DanoPTT/CellBalancer_Attiny/Balancer_osadenie.JPG

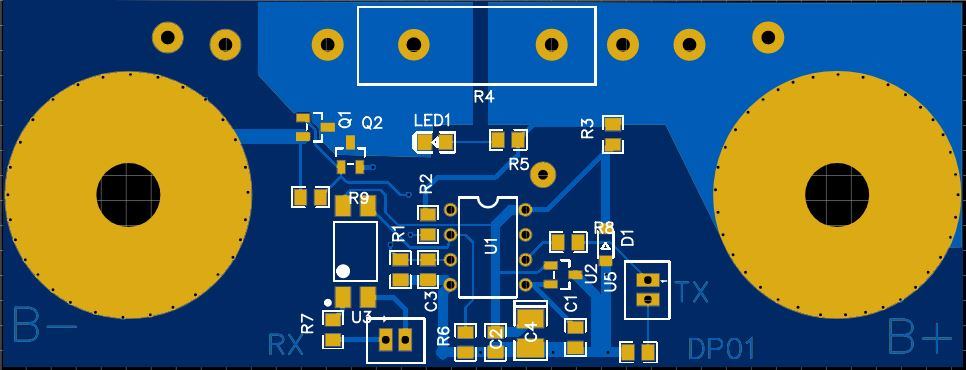
Balancer_osadenie.JPG
