DanoPTT/CellBalancer_Attiny/Pictures/Bottom.PNG

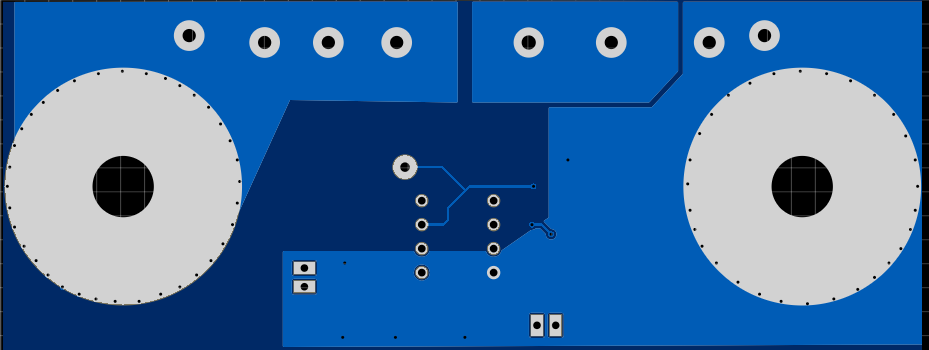
Pictures/Bottom.PNG
