DanoPTT/CellBalancer_Attiny/Schema/TXRX_Inverter.PNG

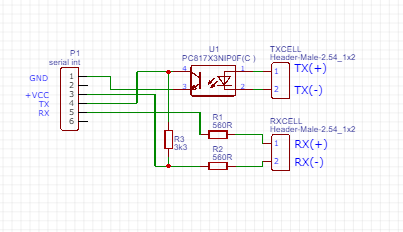
Schema/TXRX_Inverter.PNG
