DanoPTT/CellBalancer_Attiny/Pictures/FittedParts.JPG

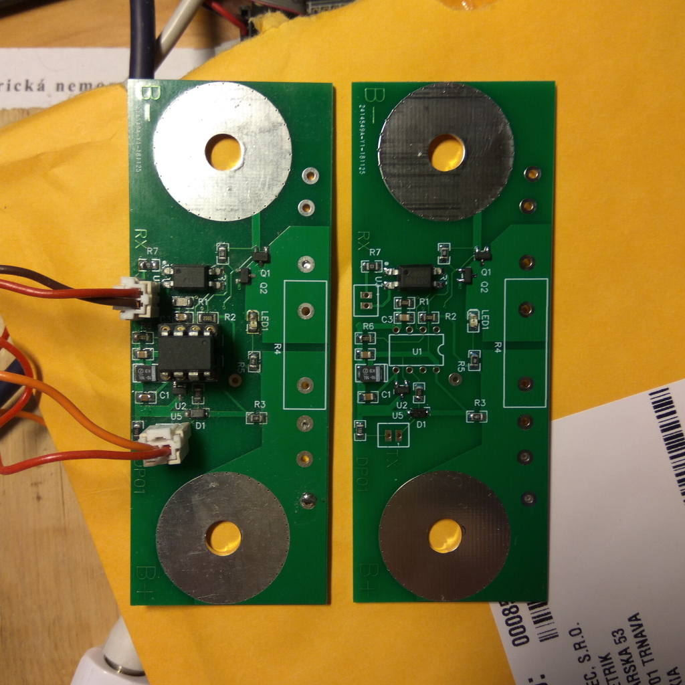
Pictures/FittedParts.JPG
