DanoPTT/CellBalancer_Attiny/Pictures/Installed.JPG

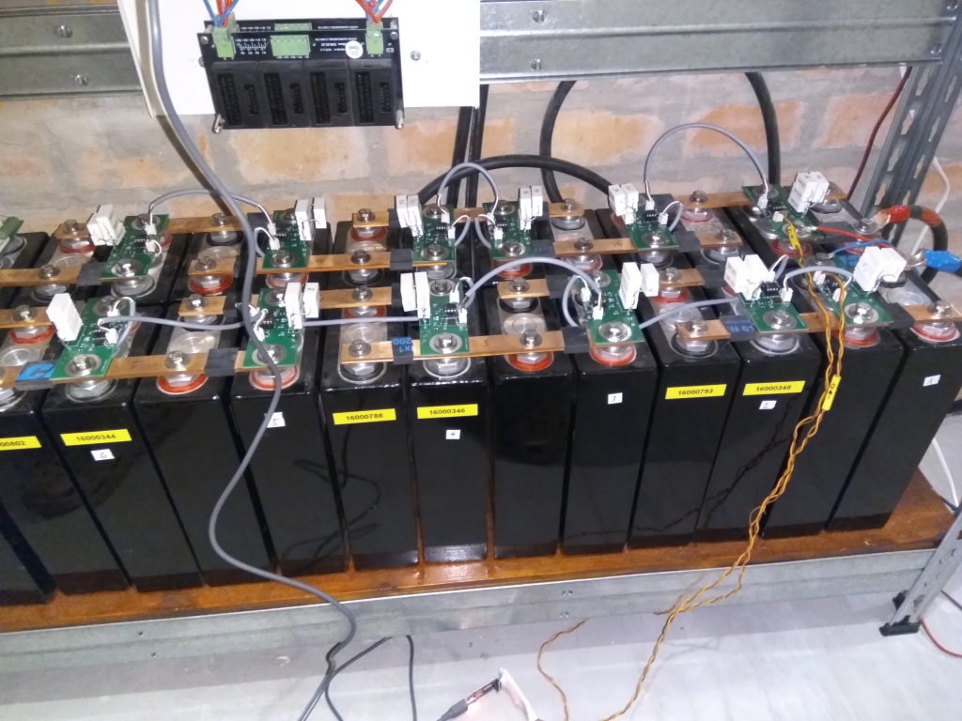
Pictures/Installed.JPG
