DanoPTT/CellBalancer_Attiny/Schema/Schematic_Cell-balancer-monitor-with-attiny85_Sheet-1_20181124230932.pdf

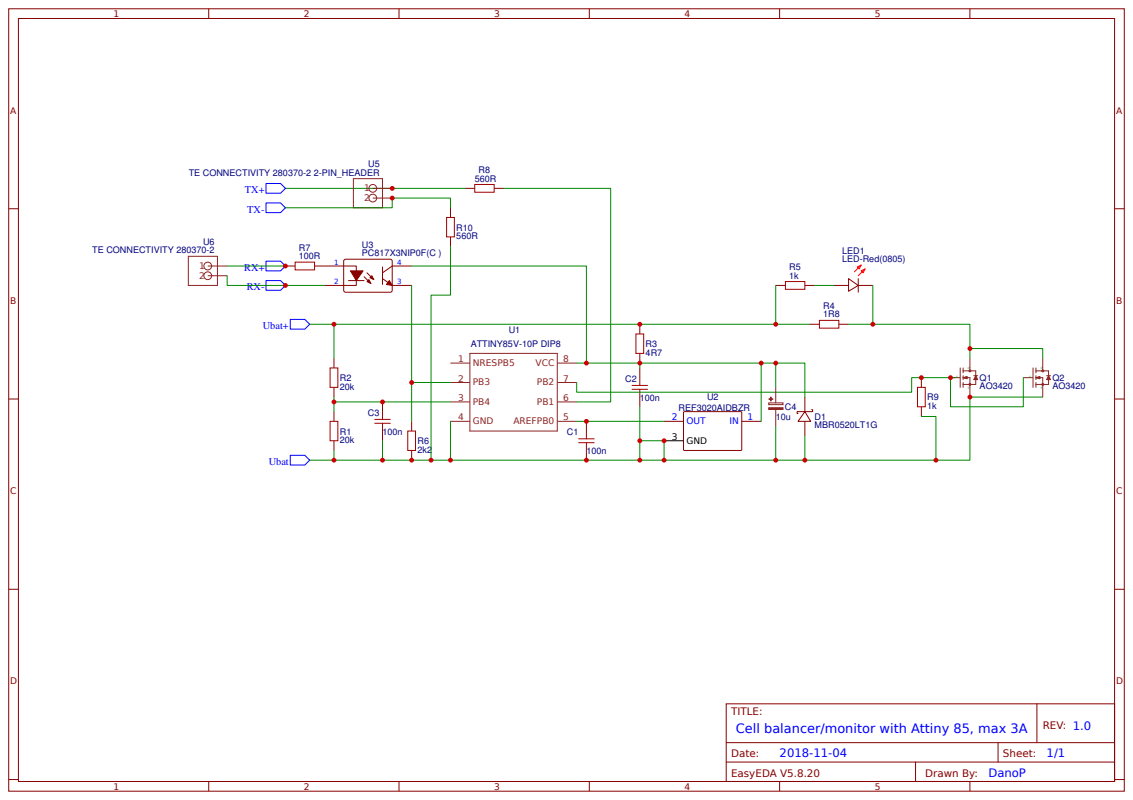
[picture p9: page 1]
