DanoPTT/CellBalancer_Attiny/(list of files, drawings)

Other design files:
EasyEda/EasyEdaExport_PCB_BAL_ATT_V01.json
