DanoPTT/CellBalancer_Attiny/(commit log)

2019-11-12 Create Calibration_osc.ino
    Used with 1MHz internal osccilator
2020-01-09 Add files via upload
    Hopefully complete EasyEda project with schema and pcb
